TheUncleKai/bbkicad/data/hammond/brd/1551F.png

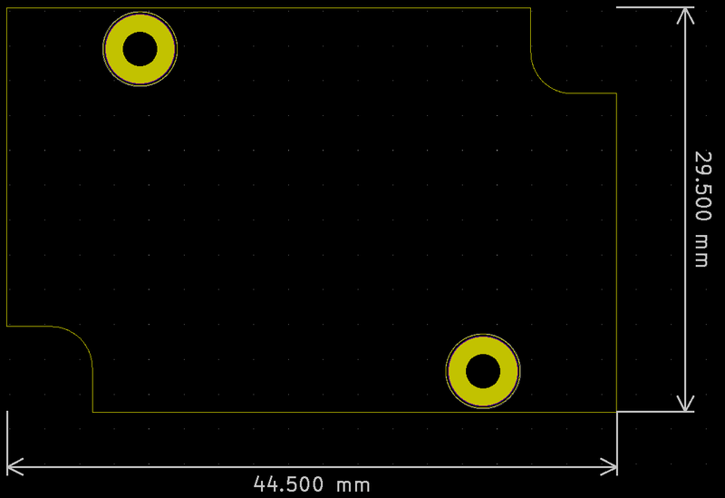
data/hammond/brd/1551F.png
