TheUncleKai/bbkicad/data/hammond/brd/1551G.png

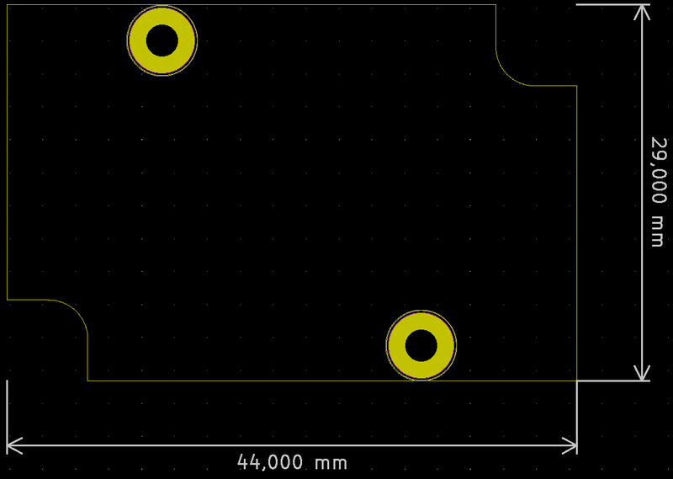
data/hammond/brd/1551G.png
