TheUncleKai/bbkicad/data/hammond/brd/1551H.png

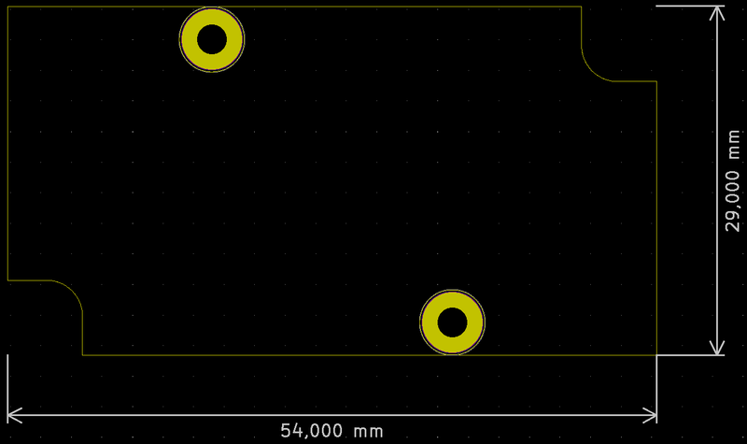
data/hammond/brd/1551H.png
