TheUncleKai/bbkicad/data/hammond/brd/1551J.png

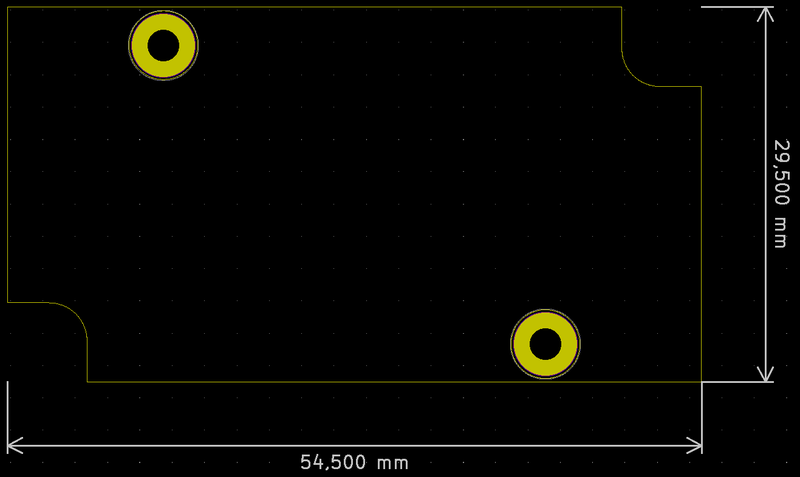
data/hammond/brd/1551J.png
