TheUncleKai/bbkicad/data/hammond/brd/1551K.png

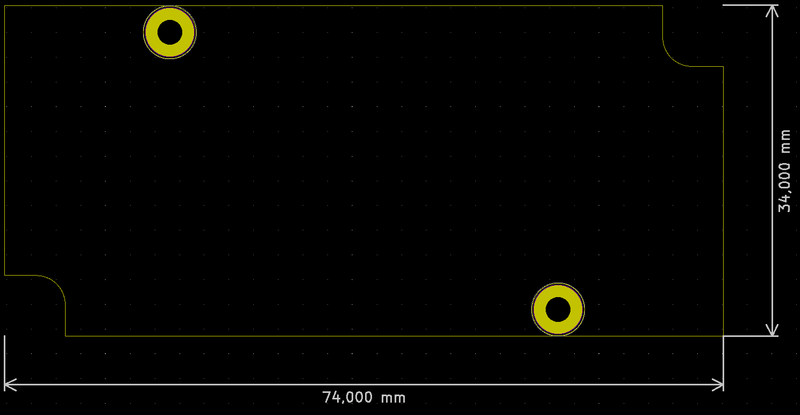
data/hammond/brd/1551K.png
