TheUncleKai/bbkicad/data/hammond/brd/1551M.png

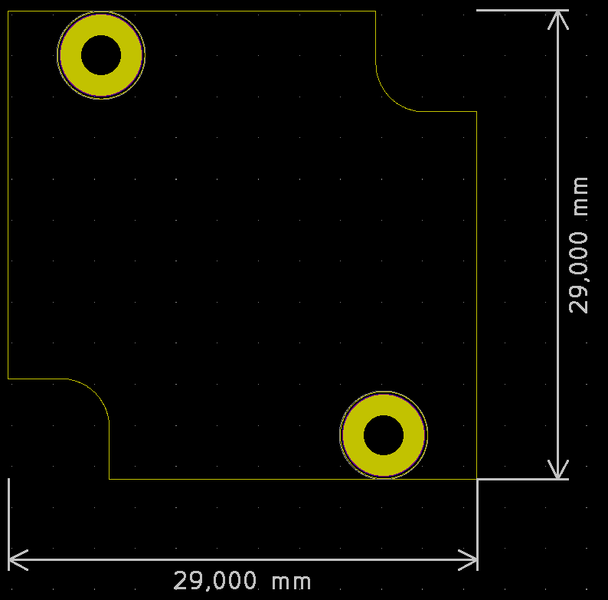
data/hammond/brd/1551M.png
