TheUncleKai/bbkicad/data/hammond/brd/1551P.png

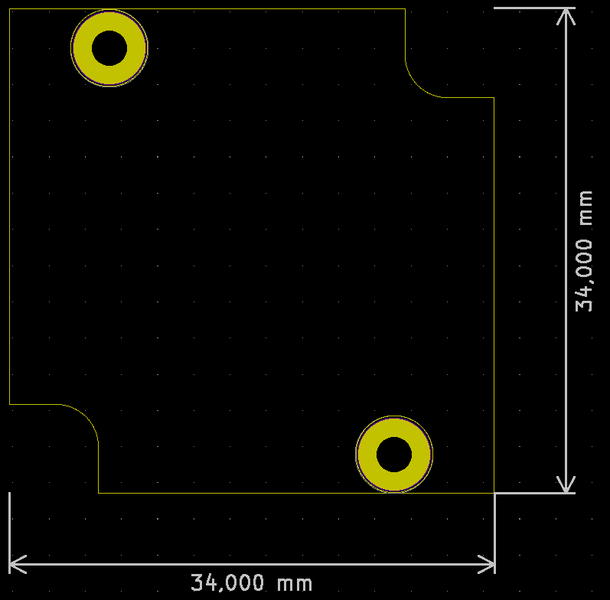
data/hammond/brd/1551P.png
