TheUncleKai/bbkicad/data/hammond/brd/1551R.png

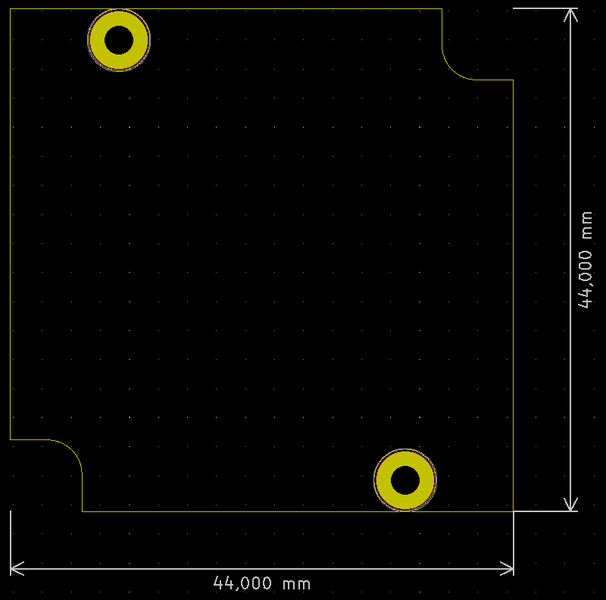
data/hammond/brd/1551R.png
