TheUncleKai/bbkicad/data/hammond/brd/1598A.png

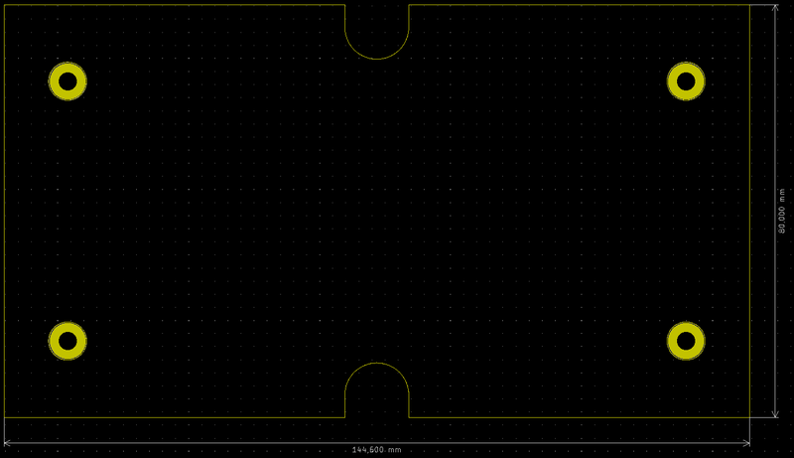
data/hammond/brd/1598A.png
