TheUncleKai/bbkicad/data/hammond/brd/1598B.png

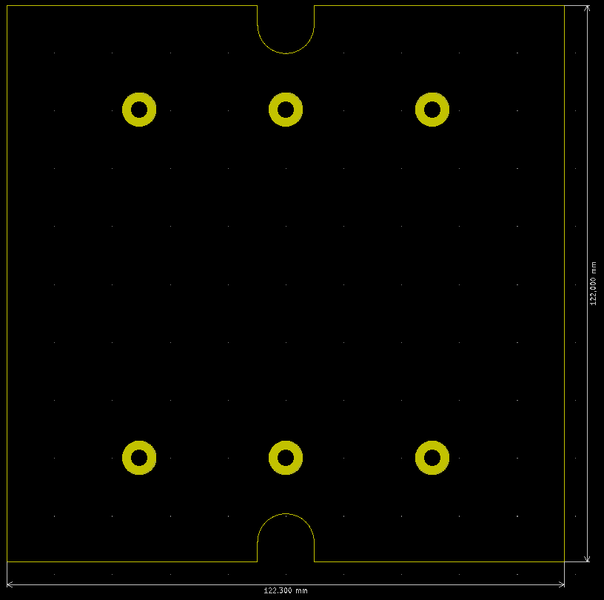
data/hammond/brd/1598B.png
