TheUncleKai/bbkicad/data/hammond/brd/1598BB.png

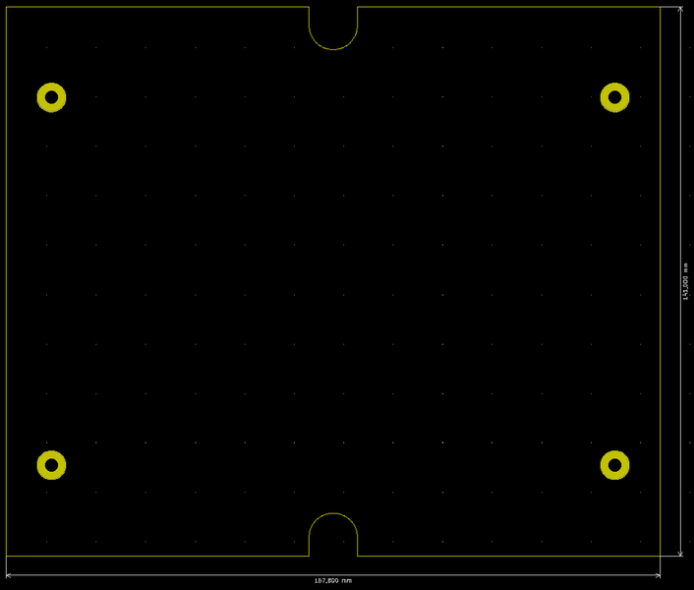
data/hammond/brd/1598BB.png
