TheUncleKai/bbkicad/data/hammond/brd/1598D.png

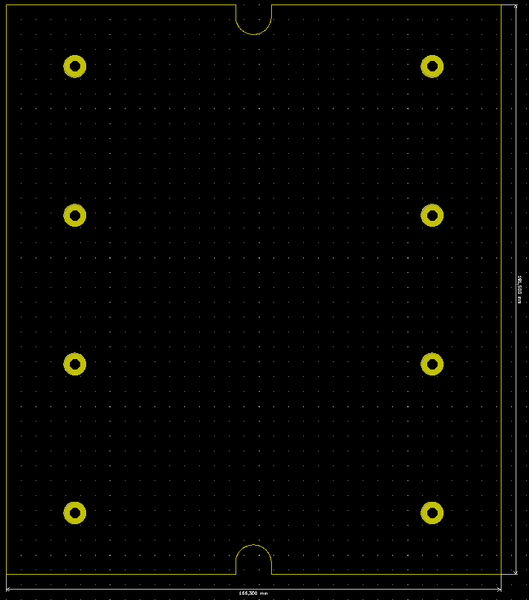
data/hammond/brd/1598D.png
