TheUncleKai/bbkicad/data/hammond/brd/1598E.png

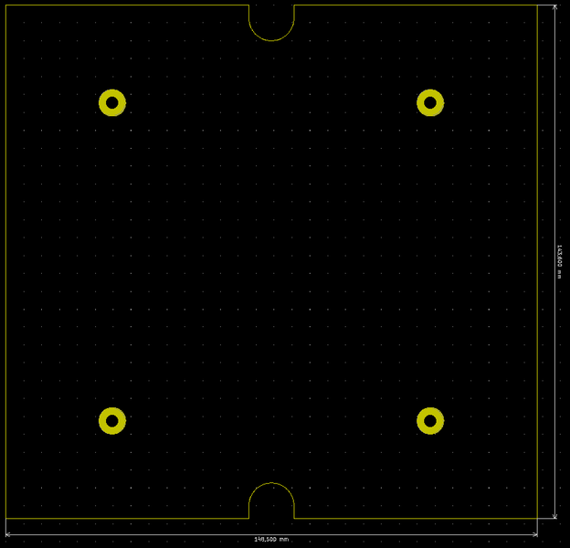
data/hammond/brd/1598E.png
