TheUncleKai/bbkicad/data/hammond/brd/1598F.png

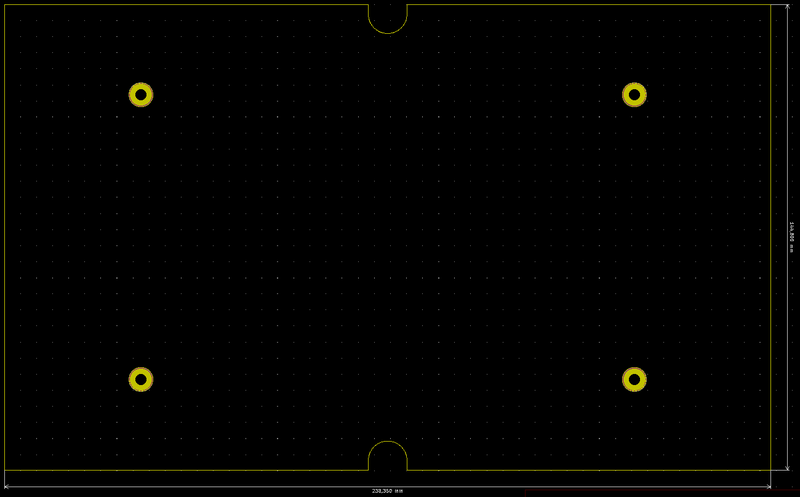
data/hammond/brd/1598F.png
