TheUncleKai/bbkicad/data/hammond/brd/1598H.png

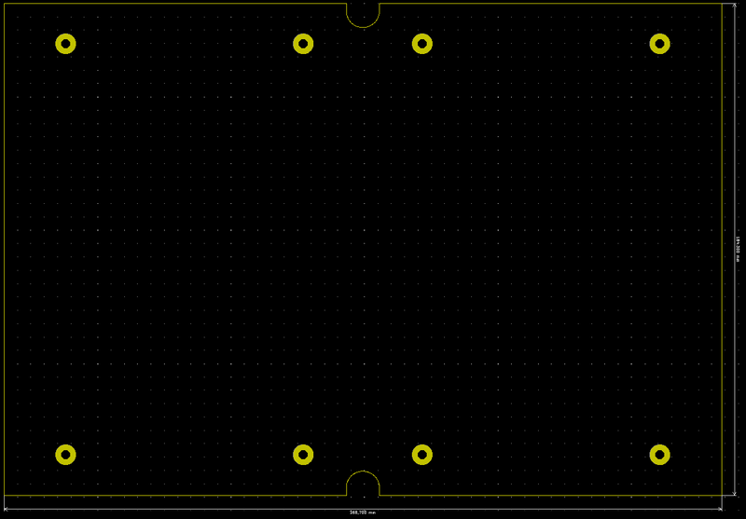
data/hammond/brd/1598H.png
