TheUncleKai/bbkicad/data/hammond/brd/1598J.png

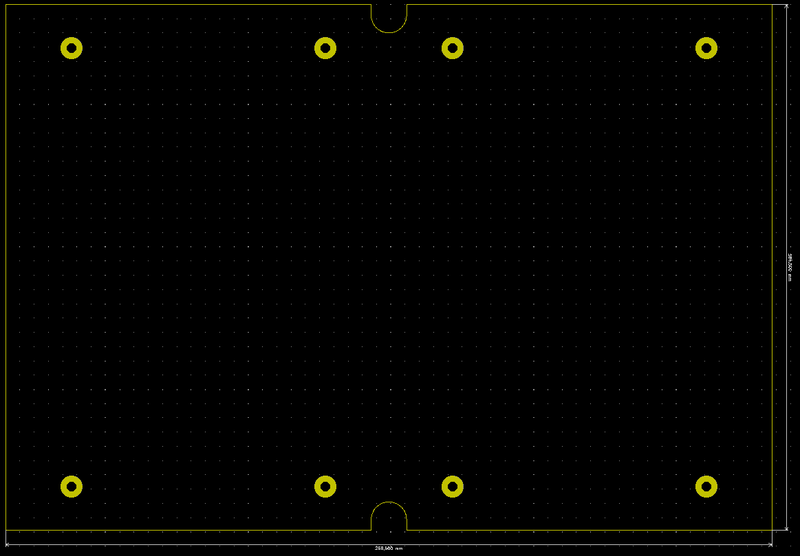
data/hammond/brd/1598J.png
