TheUncleKai/bbkicad/data/hammond/brd/RM2015L.png

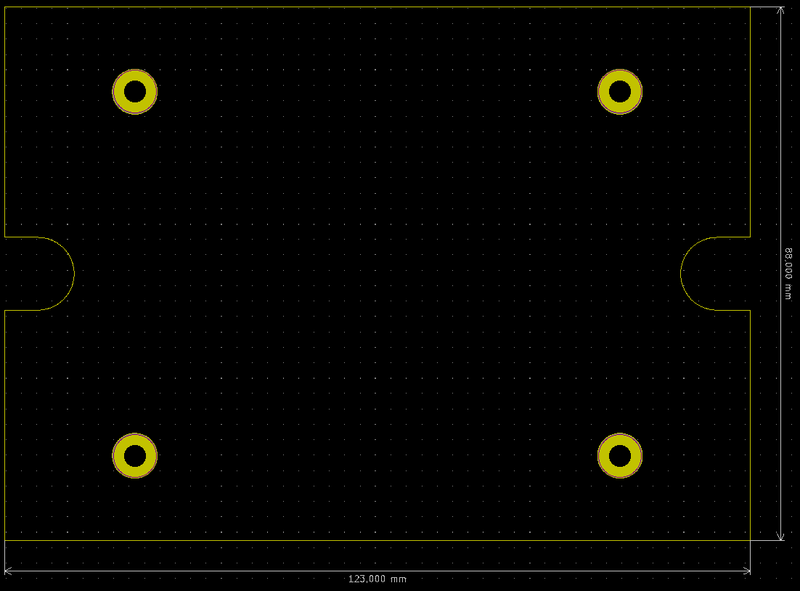
data/hammond/brd/RM2015L.png
