TheUncleKai/bbkicad/data/hammond/brd/RM2015M.png

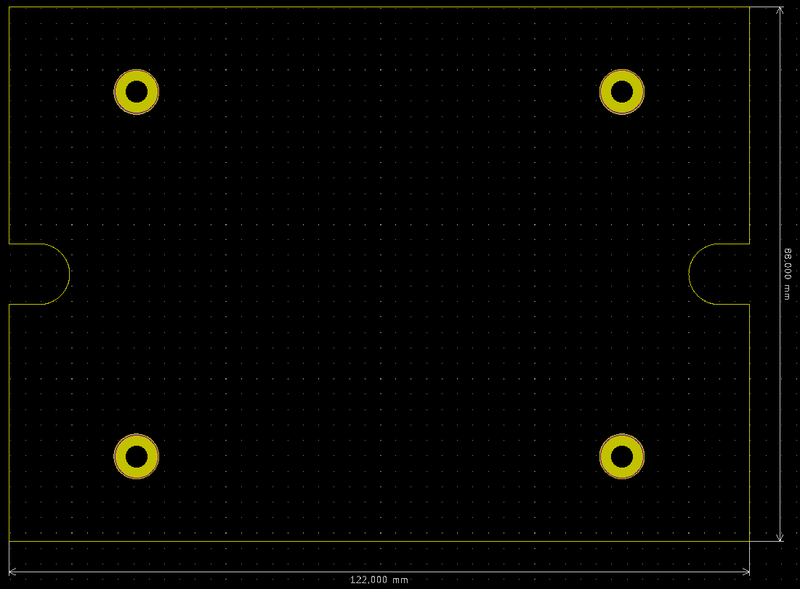
data/hammond/brd/RM2015M.png
