TheUncleKai/bbkicad/data/hammond/brd/RM2055L.png

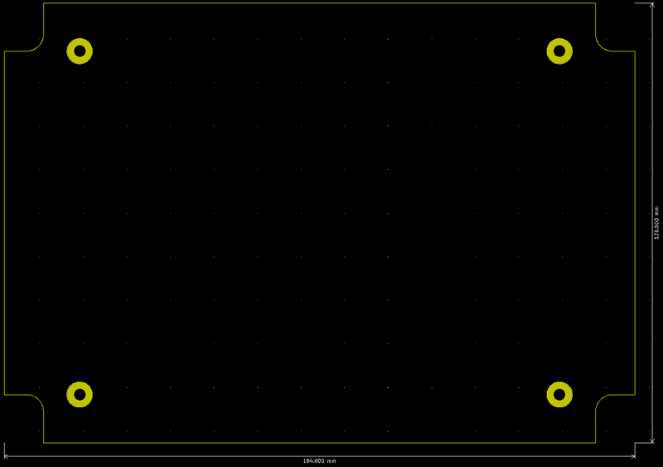
data/hammond/brd/RM2055L.png
