TheUncleKai/bbkicad/data/hammond/brd/RM2095L.png

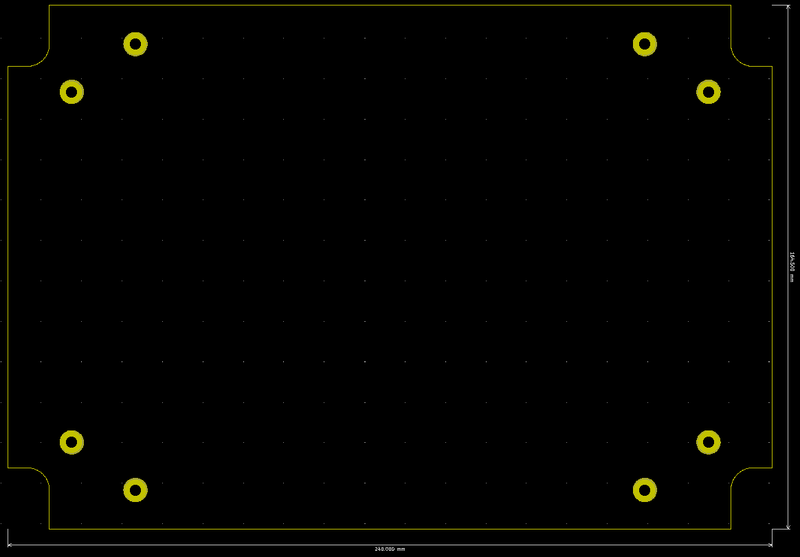
data/hammond/brd/RM2095L.png
