TheUncleKai/bbkicad/tools/Measure_100x75-F.Cu.pdf

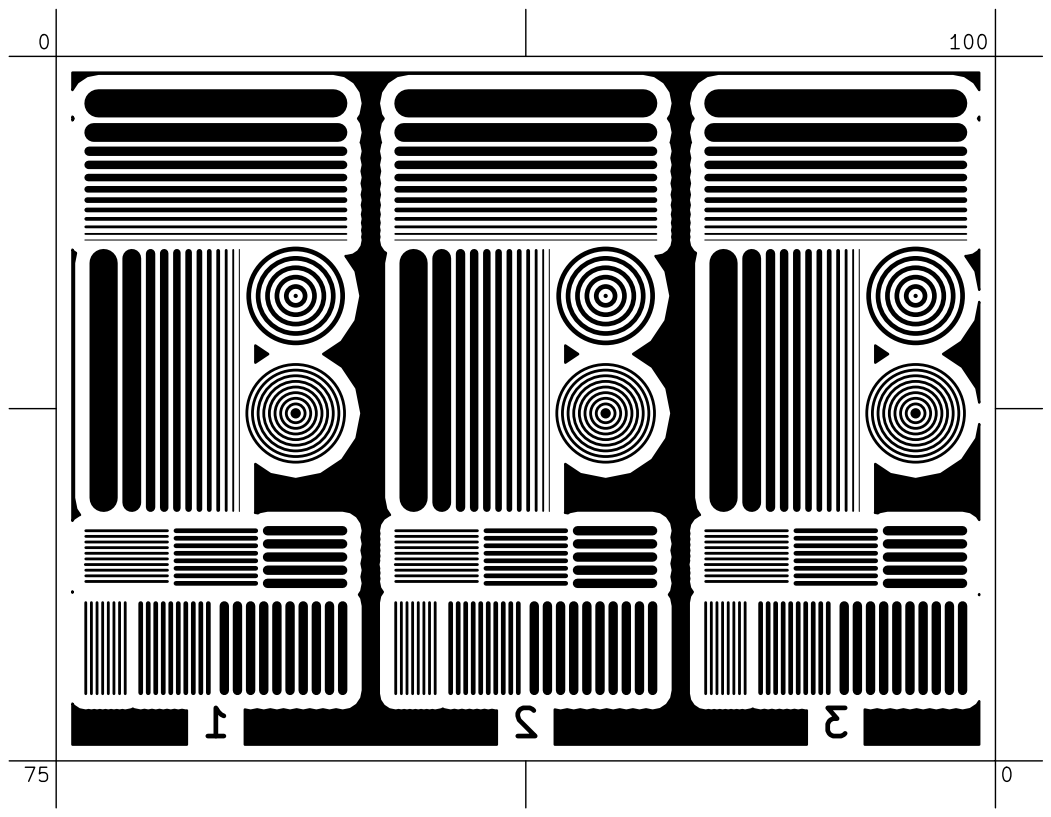
[picture p21: page 1]
