TheUncleKai/bbkicad/tools/Measure_160x100-F.Cu.pdf

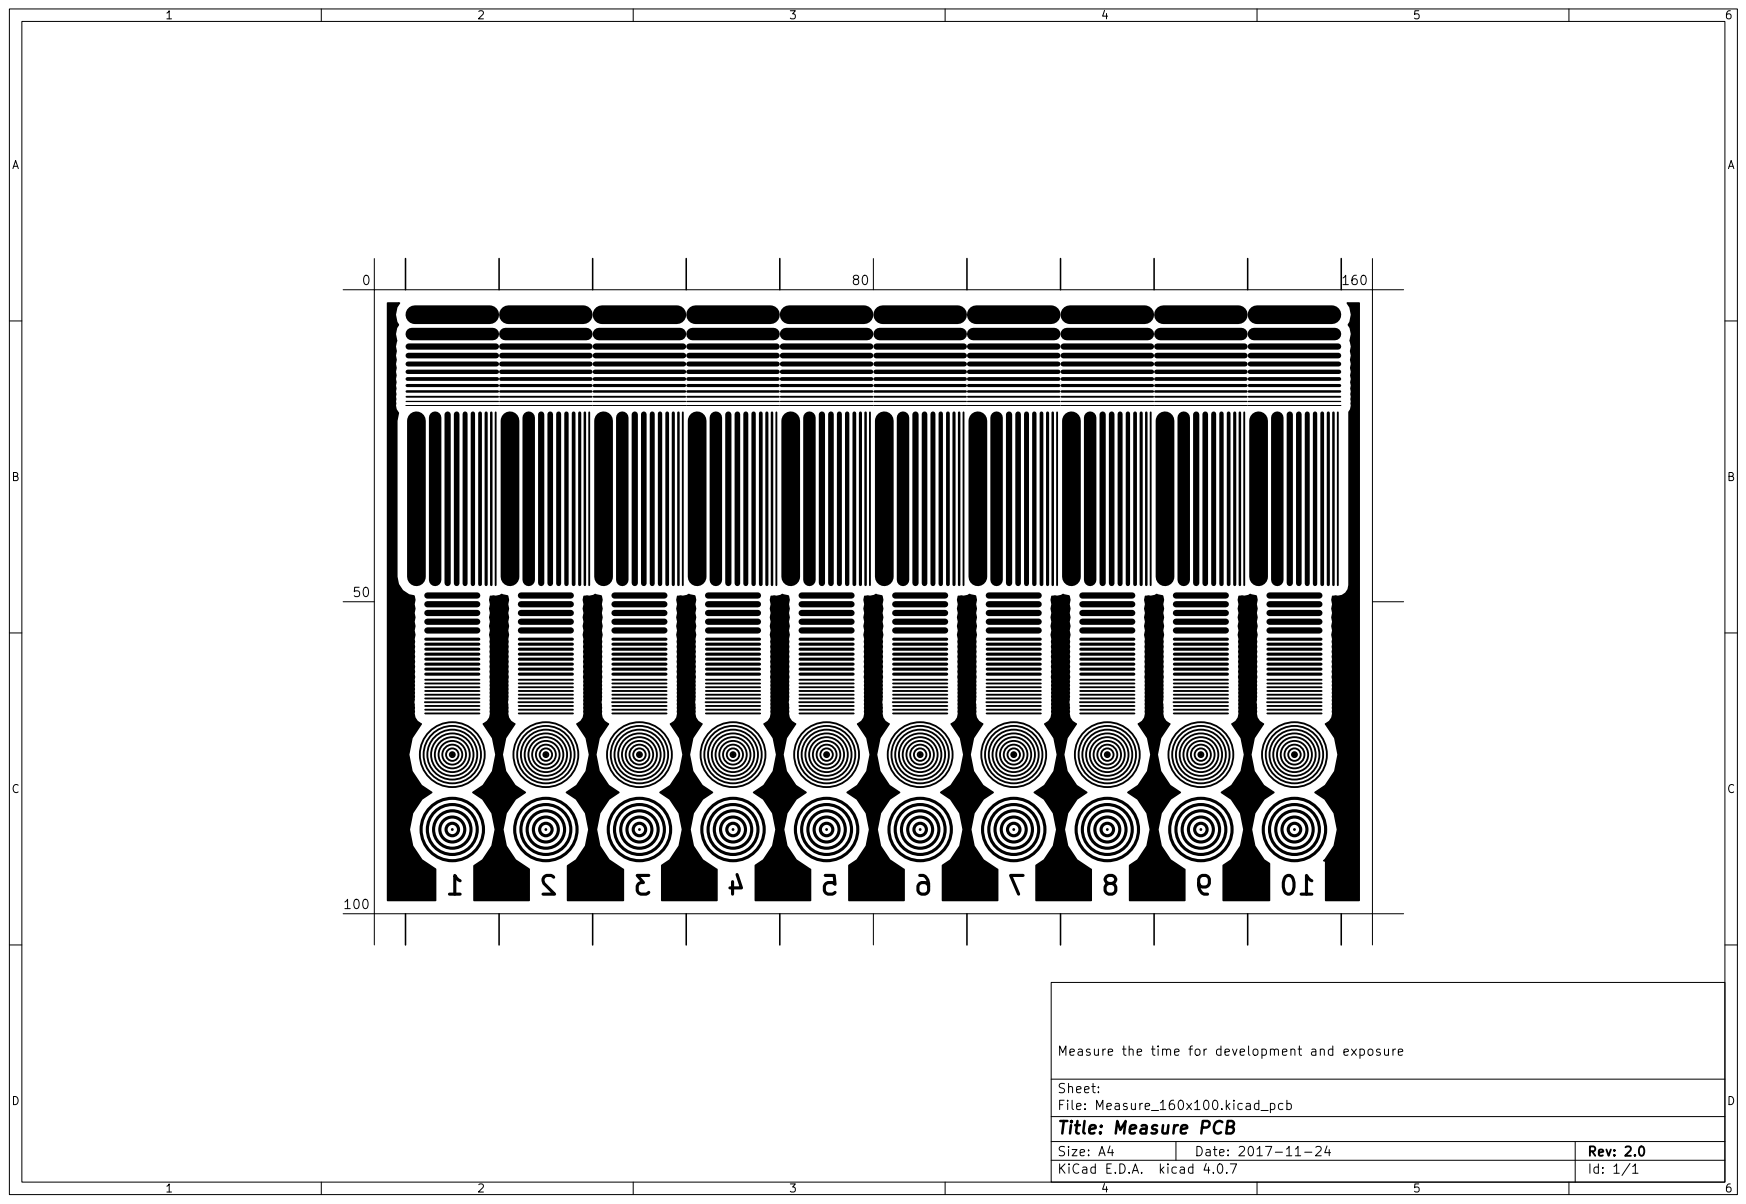
[picture p22: page 1]
