TheUncleKai/bbkicad/(commit log)

2019-08-17 Issue #1
    [BB100x75.kicad_pcb, BB100x75.sch, BB160x100.kicad_pcb, BB160x100.sch, BB233x160.kicad_pcb, BB233x160.sch, Measure_100x75.kicad_pcb, Measure_100x75.sch]
2019-08-17 feat: Convert VRML files to STEP
    switch angled box header to STEP
    Issue #2
2019-08-17 feat: Convert VRML files to STEP
    switch normal box header to STEP
    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
2019-08-17 feat: Convert VRML files to STEP
    switch Cliff Power sockets
    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
2019-08-18 feat: Convert VRML files to STEP
    use standard KiCad naming
    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
2019-08-27 feat: Convert VRML files to STEP
    add new Socket strips (elevated)
    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
2019-08-27 feat: Add experimental TO-220-3 with large PAD
    Add footprint
    Issue #4
2019-08-28 feat: Add ESP8266-E12 NodeMCI Lolin
    Add Footprint and symbols
    fix dislplay for HD4420
    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
2019-08-28 feat: Add Lumberg TRS connector
    overhaul Lumberg connector
    Issue #8
2019-08-28 feat: Add Lumberg TRS connector
    add more footprints
    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
2019-08-28 feat: VCC LED Socket 5600
    add VCC LED Socket 5600
    Issue #10
2019-08-29 feat: General bug fixes
    Fix ESP8266-12E_NodeMCU_Lolin.kicad_mod
    Issue #12
2019-08-30 feat: Enhancement
    add PX0580PC Bulgin socket
    Issue #15
2019-09-05 feat: Add Templates for Hammond Enclosures
    prepare branch
    Issue #17
2019-09-06 feat: Add Templates for Hammond Enclosures
    add Template for Hammond RM2015L
    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
    [RM2015L.kicad_pcb, RM2015L.sch]
2019-09-06 feat: Add Templates for Hammond Enclosures
    add RM2015M
    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
    [RM2015M.kicad_pcb, RM2015M.sch]
2019-09-06 feat: Add Templates for Hammond Enclosures
    <Message>
    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
    [1551F.kicad_pcb, 1551F.sch, RM2015S.kicad_pcb, RM2015S.sch, RM2055L.kicad_pcb, RM2055L.sch, RM2055M.kicad_pcb, RM2055M.sch]
2019-09-06 feat: Add Templates for Hammond Enclosures
    add templates for 1551
    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
    [1551G.kicad_pcb, 1551G.sch, 1551H.kicad_pcb, 1551H.sch]
2019-09-06 feat: Add Templates for Hammond Enclosures
    add 1551J
    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
    [1551J.kicad_pcb, 1551J.sch]
2019-09-06 feat: Add Templates for Hammond Enclosures
    add 1551K
    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
    [1551K.kicad_pcb, 1551K.sch]
2019-09-06 feat: Add Templates for Hammond Enclosures
    add 1551L
    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
    [1551L.kicad_pcb, 1551L.sch]
2019-09-06 feat: Add Templates for Hammond Enclosures
    add 1551M
    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
    [1551M.kicad_pcb, 1551M.sch]
2019-09-06 feat: Add Templates for Hammond Enclosures
    add 1551P
    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
    [1551P.kicad_pcb, 1551P.sch]
2019-09-06 feat: Add Templates for Hammond Enclosures
    add 1551Q
    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
    [1551Q.kicad_pcb, 1551Q.sch]
2019-09-06 feat: Add Templates for Hammond Enclosures
    fix sizes
    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
2019-09-06 feat: Add Templates for Hammond Enclosures
    add 1551R
    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
    [1551R.kicad_pcb, 1551R.sch]
2019-09-06 feat: Add Templates for Hammond Enclosures
    fix bugs
    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
2019-09-07 feat: Add Templates for Hammond Enclosures
    add 1598 series
    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
    [1598A.kicad_pcb, 1598A.sch, 1598B.kicad_pcb, 1598B.sch, 1598BB.kicad_pcb, 1598BB.sch, 1598C.kicad_pcb, 1598C.sch]
2019-09-07 feat: Add Templates for Hammond Enclosures
    add 1598G, fix bugs
    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
    [1598G.kicad_pcb, 1598G.sch]
2019-09-07 feat: Add Templates for Hammond Enclosures
    create template for 1598A
    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
    [1598A.kicad_pcb]
2019-09-07 feat: Add Templates for Hammond Enclosures
    fix bugs, add board images
    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
    [1551F.kicad_pcb, 1551G.kicad_pcb, 1551H.kicad_pcb, 1551J.kicad_pcb, 1551K.kicad_pcb, 1551L.kicad_pcb, 1551M.kicad_pcb, 1551P.kicad_pcb]
2019-09-07 feat: Add Templates for Hammond Enclosures
    fix mounting hole pad number
    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
    [RM2015L.kicad_pcb, RM2015M.kicad_pcb, RM2015S.kicad_pcb, RM2055L.kicad_pcb, RM2055M.kicad_pcb, RM2055S.kicad_pcb, RM2095L.kicad_pcb, RM2095M.kicad_pcb]
2019-09-07 feat: Add Templates for Hammond Enclosures
    reset drill origin
    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
    [RM2015L.kicad_pcb, RM2015M.kicad_pcb, RM2055L.kicad_pcb, RM2055M.kicad_pcb, RM2055S.kicad_pcb, RM2095L.kicad_pcb, RM2095M.kicad_pcb, RM2095S.kicad_pcb]
2019-09-07 feat: Add Templates for Hammond Enclosures
    fix rights
    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
    [RM2015M.kicad_pcb]
2019-09-07 feat: Add Templates for Hammond Enclosures
    remove cache
    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
2019-09-07 feat: Add Templates for Hammond Enclosures
    remove sizes in html
    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
2019-09-07 feat: Add Templates for Hammond Enclosures
    clean up
    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
2019-09-07 feat: Add Templates for Hammond Enclosures
    remove helper lines, redo pictures
    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
    [RM2095L.kicad_pcb, RM2095M.kicad_pcb, RM2095S.kicad_pcb]
2019-09-07 feat: Add Templates for Hammond Enclosures
    add tool to resize pictures
    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
2019-09-07 feat: Add Templates for Hammond Enclosures
    add tools for cases
    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
2019-09-07 feat: Add Templates for Hammond Enclosures
    fix origin
    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
    [1551F.kicad_pcb, 1551J.kicad_pcb, 1551L.kicad_pcb, 1551Q.kicad_pcb, 1598C.kicad_pcb, 1598D.kicad_pcb, 1598E.kicad_pcb, 1598F.kicad_pcb]
2019-09-08 feat: Add Templates for Hammond Enclosures
    add new board outlines
    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
    [1598D.kicad_pcb, 1598E.kicad_pcb, 1598F.kicad_pcb, 1598G.kicad_pcb, 1598H.kicad_pcb]
2019-09-08 feat: Add Templates for Hammond Enclosures
    finish boards for 1598
    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
    [1598J.kicad_pcb]
2019-09-08 feat: Add Templates for Hammond Enclosures
    add case pictures
    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
2019-09-08 feat: Add Templates for Hammond Enclosures
    resize images
    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
2019-09-08 feat: Add Templates for Hammond Enclosures
    add panel size, fix body tag
    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
2019-09-08 feat: General bug fixes
    fix bugs in Lumberg footprints
    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
2019-09-10 feat: General bug fixes
    fix footprints
    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
2019-11-07 feat: Enhancement
    fix NAMAE push buttons
    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
2019-12-03 feat: Add AZ-Delivery ESP-32 NodeMCU Development Board
    add ESP-32_NodeMCU.kicad_mod
    Issue #28
2019-12-03 feat: Add AZ-Delivery ESP-32 NodeMCU Development Board
    Add symbol for ESP-32
    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
2020-03-01 feat: Add AZ-Delivery ESP-32 NodeMCU Development Board
    add MKDS connectors
    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
